BoliboliWJY/Stewart_Platform_Motion_Simulator/README.md

# 使用方案

## 烧入单片机代码

## 使用py命令

模拟三级海况（吴淞号）
`python play_6dof_to_platform.py --csv motion_capture/sea_state_3_WuSong/realistic_ship_6dof.csv --port COM7 --seconds 10 --translation-scale 0 --rotation-scale 1 --playback-speed 1 --send`
