BoliboliWJY/Stewart_Platform_Motion_Simulator/stl_files/Case_Bottom_slots_inward_3mm.stl

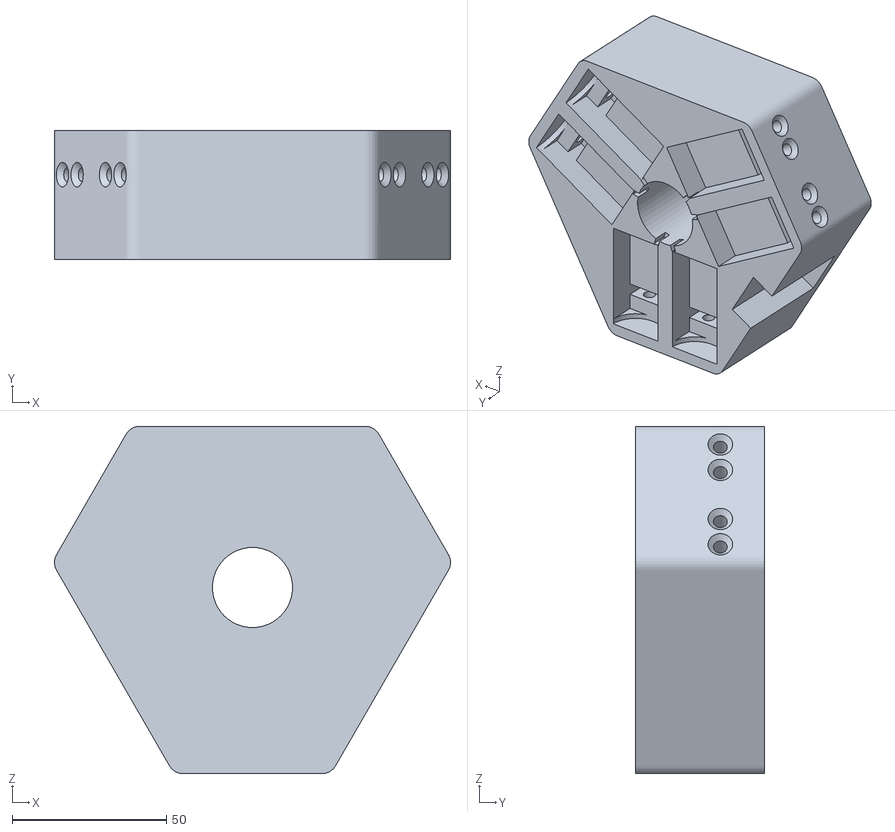
[picture p1: CAD file, 2026-11-11]
stl_files/Case_Bottom_slots_inward_3mm.stl
128.5 x 42.0 x 112.7
