BoliboliWJY/Stewart_Platform_Motion_Simulator/(list of files, cad)

Other CAD files:
stl_files/Case_Bottom_six_slots_segments_shortened_3mm.stl
stl_files/Case_Bottom_supports_shortened_3mm.stl
